VeslRuben/Luretiks-Slange/Pictures/test2jallball.jpg

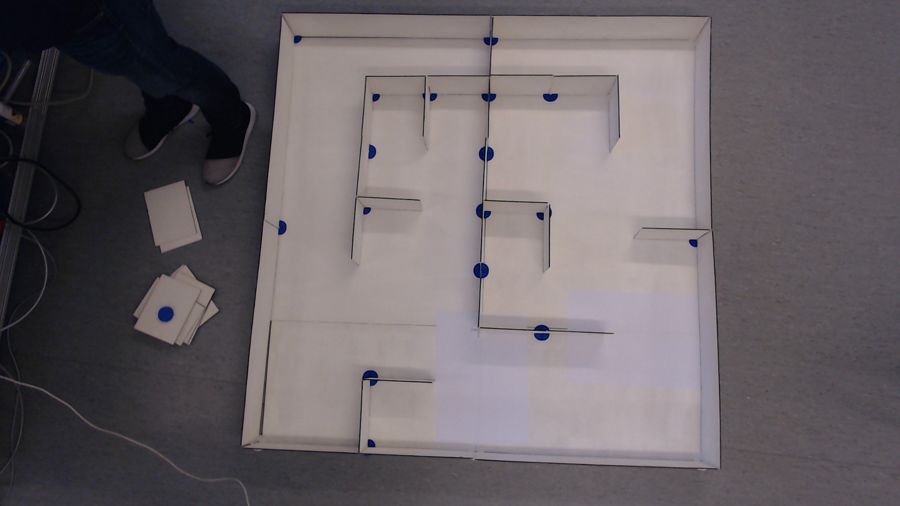
Pictures/test2jallball.jpg
