VeslRuben/Luretiks-Slange/Pictures/Front kamera/8.jpeg

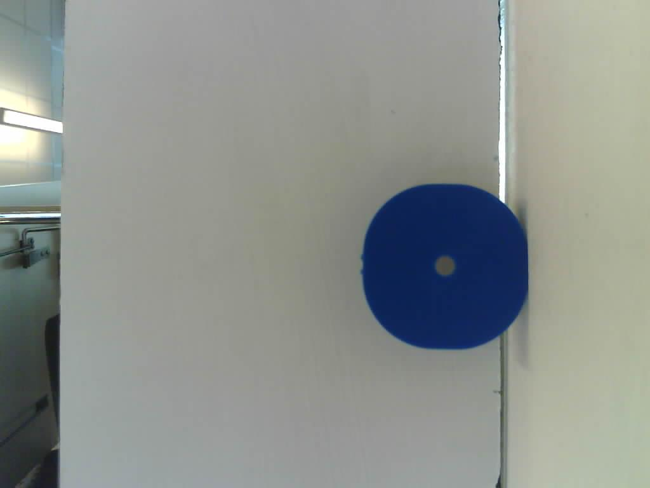
Pictures/Front kamera/8.jpeg
