VeslRuben/Luretiks-Slange/Documents/Handleliste.docx

# Components needed:

- ESP32
- Logic Level Shifter, 8 channel - https://no.rs-online.com/web/p/processor-microcontroller-development-kits/1346479/
- 6x Batteries - https://no.rs-online.com/web/p/lithium-rechargeable-batteries/1251266/
  - Optimal with 6 batteries, minimum requirement is 3 batteries.
