VeslRuben/Luretiks-Slange/Documents/graf.png

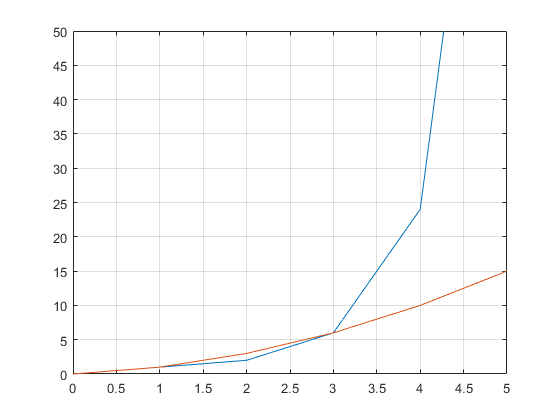
Documents/graf.png
