VeslRuben/Luretiks-Slange/Documents/ingeniorgui.png

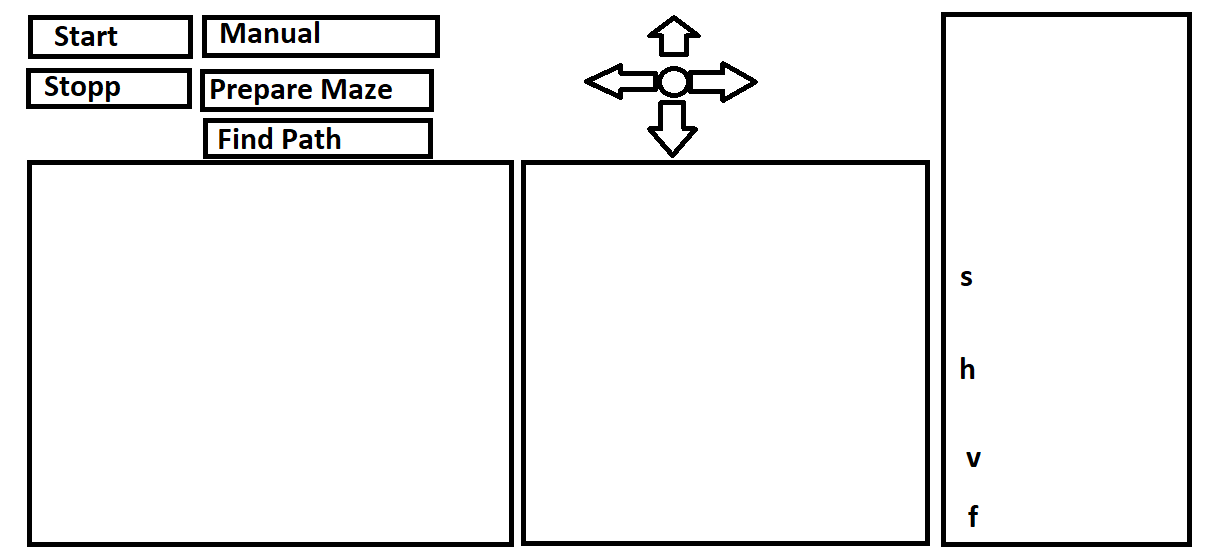
Documents/ingeniorgui.png
