VeslRuben/Luretiks-Slange/Documents/maskebilde1.png

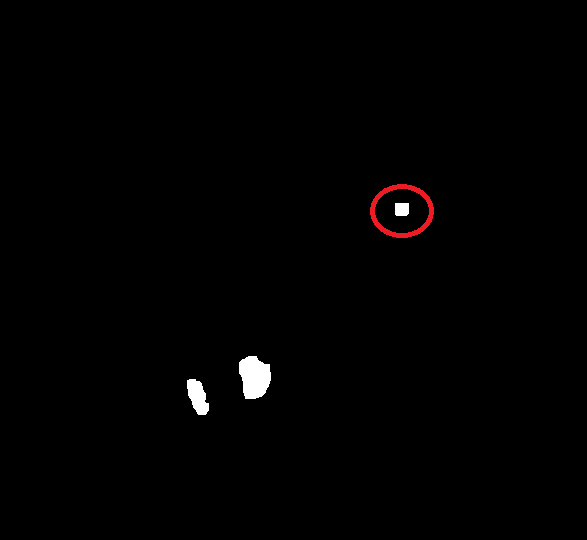
Documents/maskebilde1.png
