VeslRuben/Luretiks-Slange/Documents/maskebilde2.png

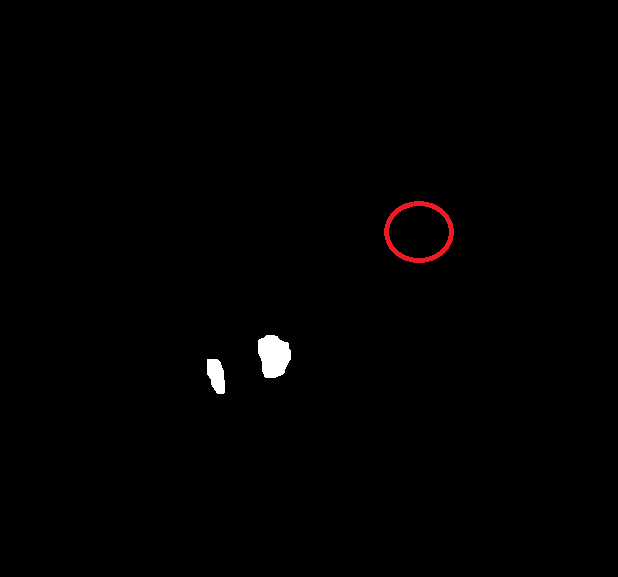
Documents/maskebilde2.png
