VeslRuben/Luretiks-Slange/Documents/mazepic.jpg

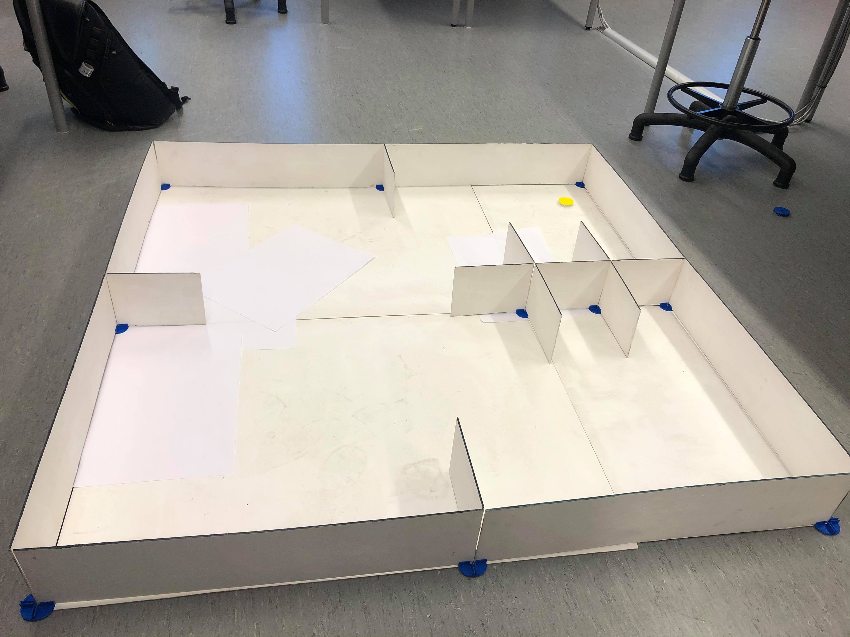
Documents/mazepic.jpg
