VeslRuben/Luretiks-Slange/Pictures/DeadEnds/DeadEnd1.PNG

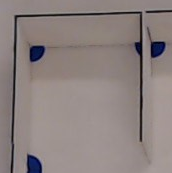
Pictures/DeadEnds/DeadEnd1.PNG
