VeslRuben/Luretiks-Slange/Pictures/DeadEnds/DeadEnd2.PNG

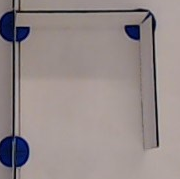
Pictures/DeadEnds/DeadEnd2.PNG
