VeslRuben/Luretiks-Slange/Pictures/DeadEnds/DeadEnd3.PNG

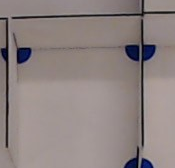
Pictures/DeadEnds/DeadEnd3.PNG
