VeslRuben/Luretiks-Slange/Pictures/DeadEnds/DeadEnd6.PNG

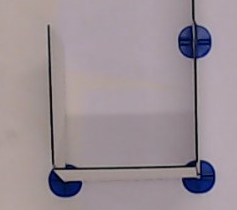
Pictures/DeadEnds/DeadEnd6.PNG
