VeslRuben/Luretiks-Slange/Pictures/DeadEnds/DeadEnd7.PNG

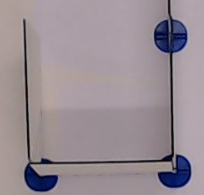
Pictures/DeadEnds/DeadEnd7.PNG
