VeslRuben/Luretiks-Slange/Pictures/DeadEnds/DeadEnd8.PNG

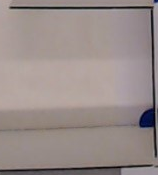
Pictures/DeadEnds/DeadEnd8.PNG
