VeslRuben/Luretiks-Slange/Pictures/DeadEnds/DeadEnd9.PNG

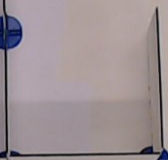
Pictures/DeadEnds/DeadEnd9.PNG
