VeslRuben/Luretiks-Slange/Pictures/DeadEnds/DeadEnd10.PNG

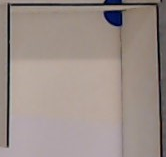
Pictures/DeadEnds/DeadEnd10.PNG
