VeslRuben/Luretiks-Slange/Pictures/DeadEnds/DeadEnd11.PNG

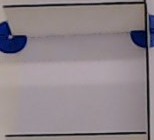
Pictures/DeadEnds/DeadEnd11.PNG
