VeslRuben/Luretiks-Slange/Pictures/DeadEnds/DeadEnd12.PNG

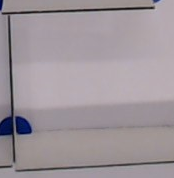
Pictures/DeadEnds/DeadEnd12.PNG
