VeslRuben/Luretiks-Slange/Pictures/DeadEnds/DeadEnd13.PNG

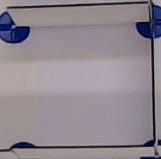
Pictures/DeadEnds/DeadEnd13.PNG
