VeslRuben/Luretiks-Slange/Pictures/DeadEnds/DeadEnd14.PNG

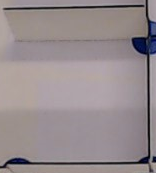
Pictures/DeadEnds/DeadEnd14.PNG
