VeslRuben/Luretiks-Slange/Pictures/DeadEnds/DeadEnd15.PNG

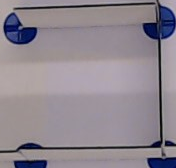
Pictures/DeadEnds/DeadEnd15.PNG
