VeslRuben/Luretiks-Slange/Pictures/DeadEnds/DeadEnd16.PNG

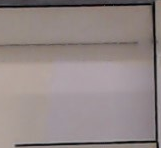
Pictures/DeadEnds/DeadEnd16.PNG
