VeslRuben/Luretiks-Slange/Pictures/DeadEnds/DeadEnd17.PNG

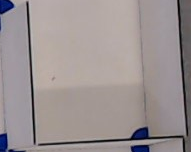
Pictures/DeadEnds/DeadEnd17.PNG
