VeslRuben/Luretiks-Slange/Pictures/DeadEnds/DeadEnd18.PNG

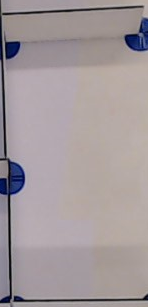
Pictures/DeadEnds/DeadEnd18.PNG
