VeslRuben/Luretiks-Slange/Pictures/DeadEnds/DeadEnd20.PNG

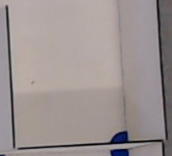
Pictures/DeadEnds/DeadEnd20.PNG
