VeslRuben/Luretiks-Slange/Pictures/DeadEnds/DeadEnd21.PNG

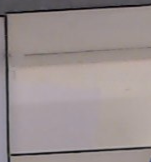
Pictures/DeadEnds/DeadEnd21.PNG
