VeslRuben/Luretiks-Slange/Pictures/DeadEnds/DeadEnd22.PNG

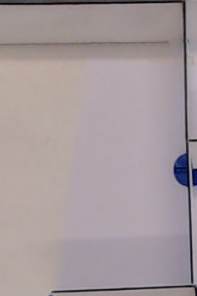
Pictures/DeadEnds/DeadEnd22.PNG
