VeslRuben/Luretiks-Slange/Pictures/DeadEnds/DeadEnd23.PNG

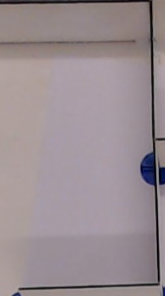
Pictures/DeadEnds/DeadEnd23.PNG
