VeslRuben/Luretiks-Slange/Pictures/DeadEnds/DeadEnd24.PNG

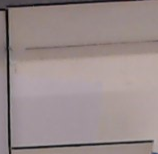
Pictures/DeadEnds/DeadEnd24.PNG
