VeslRuben/Luretiks-Slange/Pictures/DeadEnds/DeadEnd25.PNG

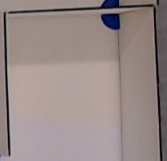
Pictures/DeadEnds/DeadEnd25.PNG
