VeslRuben/Luretiks-Slange/Pictures/DeadEnds/DeadEnd26.PNG

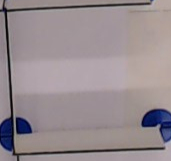
Pictures/DeadEnds/DeadEnd26.PNG
