VeslRuben/Luretiks-Slange/Pictures/DeadEnds/DeadEnd27.PNG

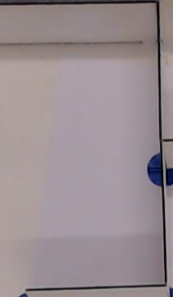
Pictures/DeadEnds/DeadEnd27.PNG
