VeslRuben/Luretiks-Slange/Pictures/DeadEnds/DeadEnd28.PNG

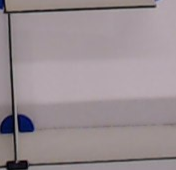
Pictures/DeadEnds/DeadEnd28.PNG
