VeslRuben/Luretiks-Slange/Pictures/DeadEnds/DeadEnd29.PNG

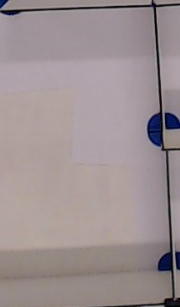
Pictures/DeadEnds/DeadEnd29.PNG
