VeslRuben/Luretiks-Slange/Pictures/DeadEnds/DeadEnd31.PNG

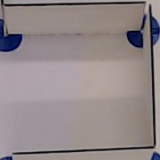
Pictures/DeadEnds/DeadEnd31.PNG
