VeslRuben/Luretiks-Slange/Pictures/DeadEnds/DeadEnd32.PNG

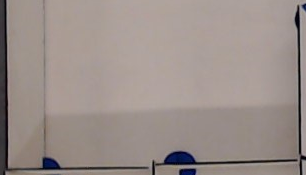
Pictures/DeadEnds/DeadEnd32.PNG
