VeslRuben/Luretiks-Slange/Pictures/DeadEnds/DeadEnd33.PNG

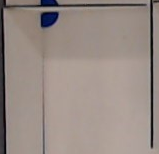
Pictures/DeadEnds/DeadEnd33.PNG
