VeslRuben/Luretiks-Slange/Pictures/DeadEnds/DeadEnd34.PNG

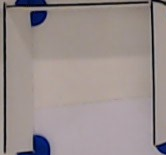
Pictures/DeadEnds/DeadEnd34.PNG
