VeslRuben/Luretiks-Slange/Pictures/DeadEnds/DeadEnd37.PNG

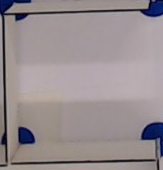
Pictures/DeadEnds/DeadEnd37.PNG
