VeslRuben/Luretiks-Slange/Pictures/DeadEnds/DeadEnd38.PNG

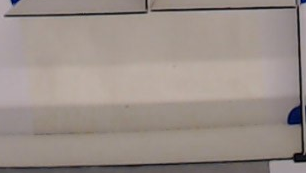
Pictures/DeadEnds/DeadEnd38.PNG
