VeslRuben/Luretiks-Slange/Pictures/DeadEnds/DeadEnd39.PNG

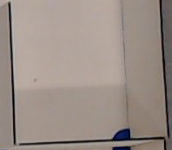
Pictures/DeadEnds/DeadEnd39.PNG
