VeslRuben/Luretiks-Slange/Pictures/DeadEnds/DeadEnd40.PNG

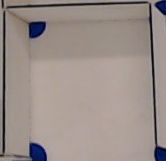
Pictures/DeadEnds/DeadEnd40.PNG
