VeslRuben/Luretiks-Slange/Pictures/DeadEnds/DeadEnd41.PNG

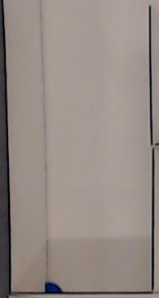
Pictures/DeadEnds/DeadEnd41.PNG
