VeslRuben/Luretiks-Slange/Pictures/DeadEnds/DeadEnd44.PNG

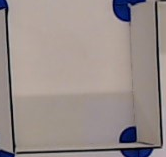
Pictures/DeadEnds/DeadEnd44.PNG
