VeslRuben/Luretiks-Slange/Pictures/DeadEnds/DeadEnd45.PNG

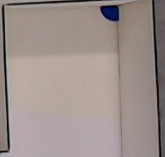
Pictures/DeadEnds/DeadEnd45.PNG
