VeslRuben/Luretiks-Slange/Pictures/DeadEnds/DeadEnd46.PNG

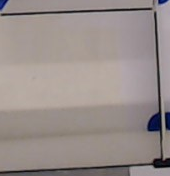
Pictures/DeadEnds/DeadEnd46.PNG
