VeslRuben/Luretiks-Slange/Pictures/Front kamera/0.jpeg

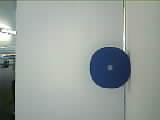
Pictures/Front kamera/0.jpeg
