VeslRuben/Luretiks-Slange/Pictures/Front kamera/6.jpeg

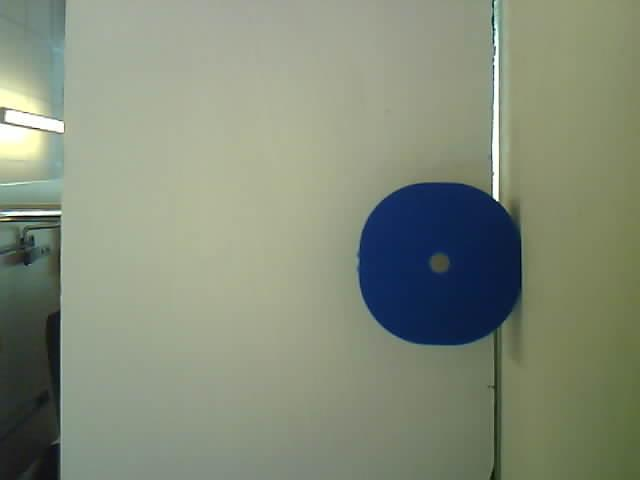
Pictures/Front kamera/6.jpeg
