VeslRuben/Luretiks-Slange/Pictures/jall2.jpg

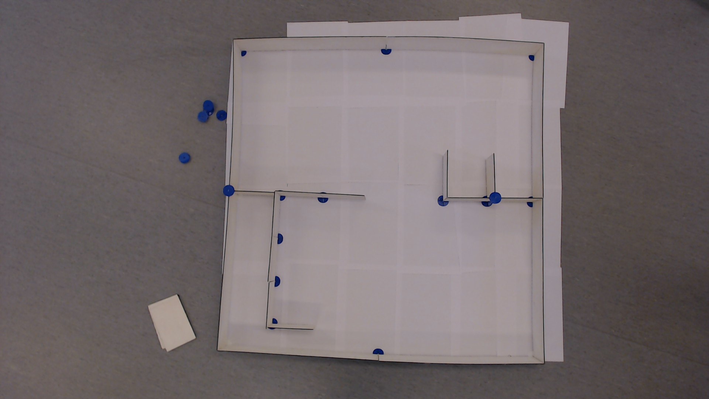
Pictures/jall2.jpg
