VeslRuben/Luretiks-Slange/Pictures/jallaball2.jpg

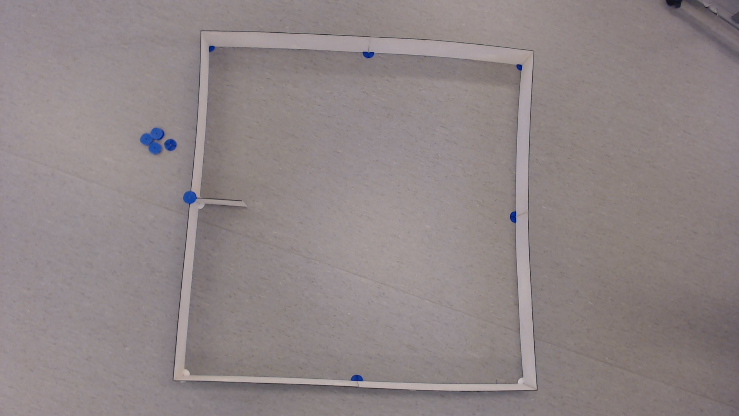
Pictures/jallaball2.jpg
