VeslRuben/Luretiks-Slange/Pictures/jallabilde1.jpg

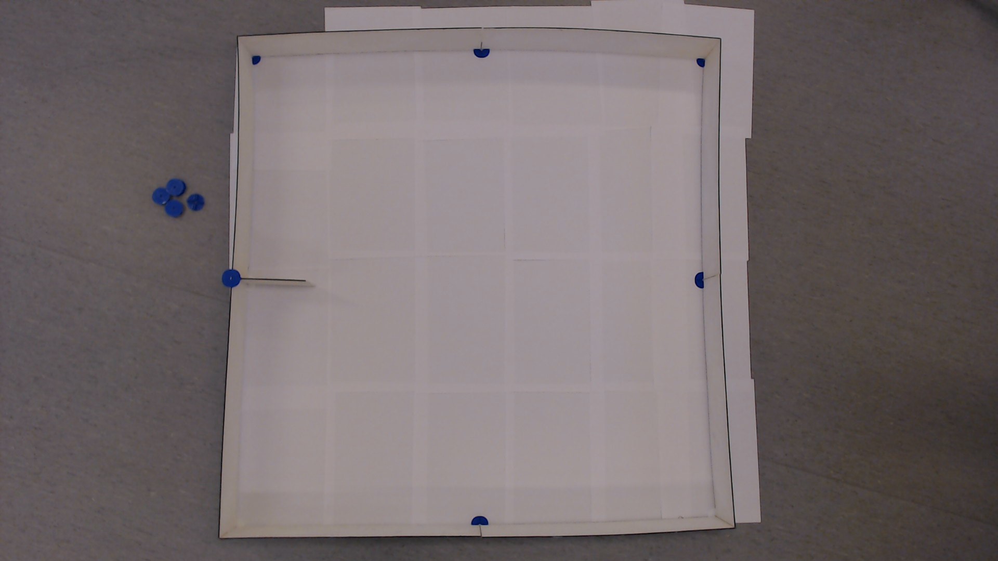
Pictures/jallabilde1.jpg
