VeslRuben/Luretiks-Slange/Pictures/WIN_20191023_11_11_40_Pro.jpg

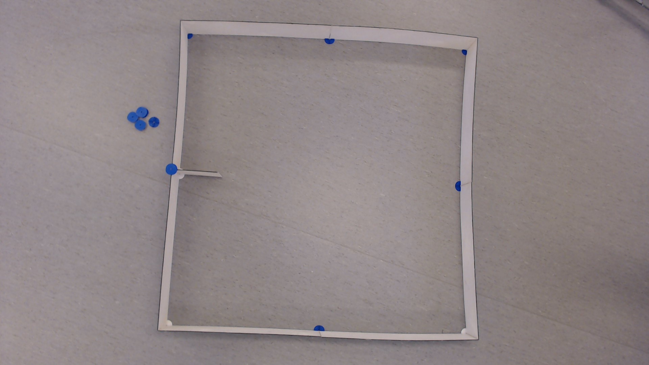
Pictures/WIN_20191023_11_11_40_Pro.jpg
