VeslRuben/Luretiks-Slange/Pictures/WIN_20191023_11_20_51_Pro.jpg

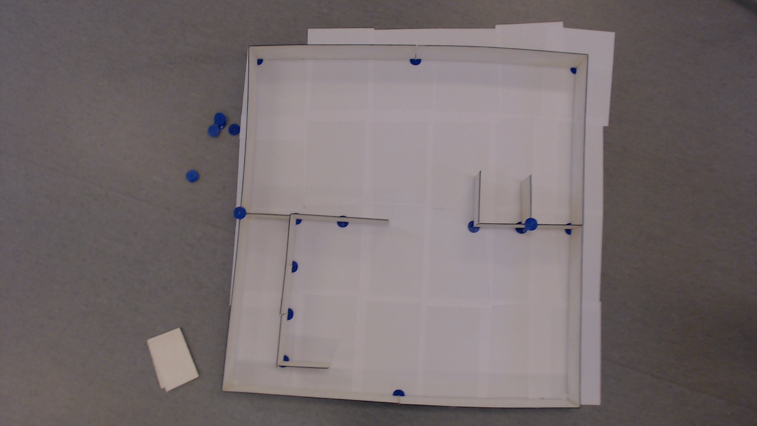
Pictures/WIN_20191023_11_20_51_Pro.jpg
