VeslRuben/Luretiks-Slange/Pictures/WIN_20191023_11_20_55_Pro.jpg

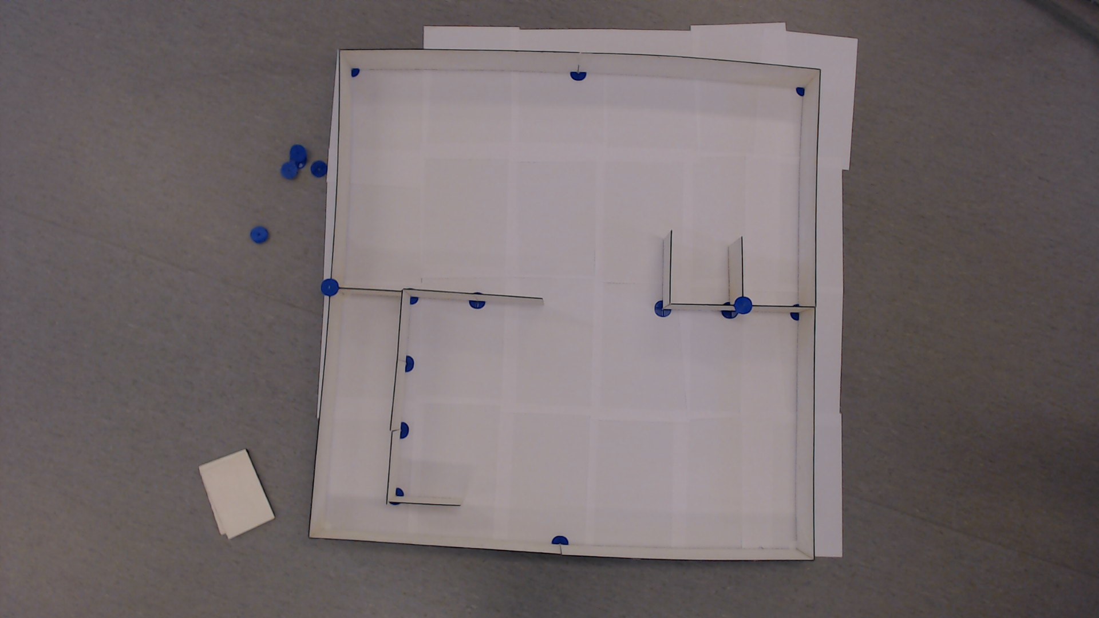
Pictures/WIN_20191023_11_20_55_Pro.jpg
