VeslRuben/Luretiks-Slange/Tegning/Untitled Diagram.png

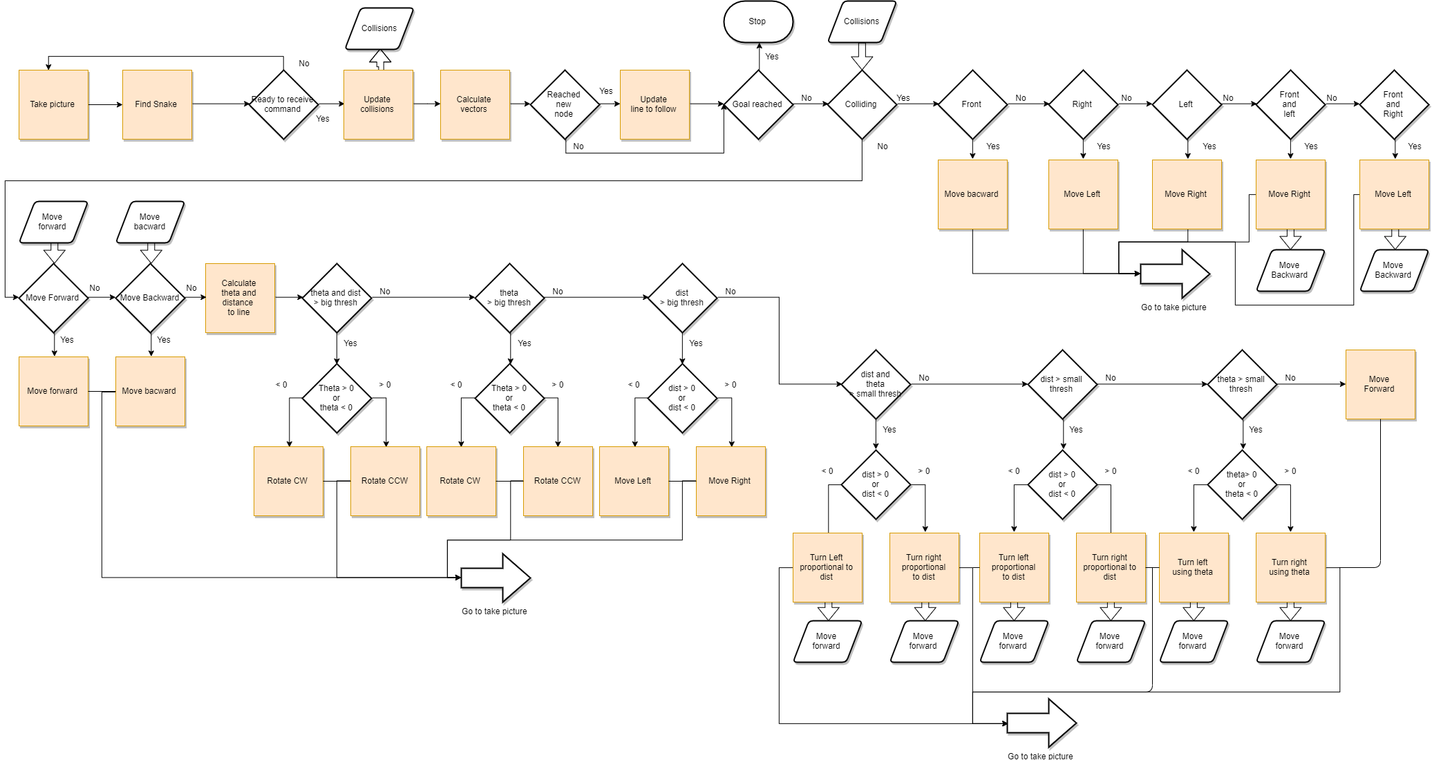
Tegning/Untitled Diagram.png
