VeslRuben/Luretiks-Slange/Tegning/Gcode/UM2_vegg holder.3mf

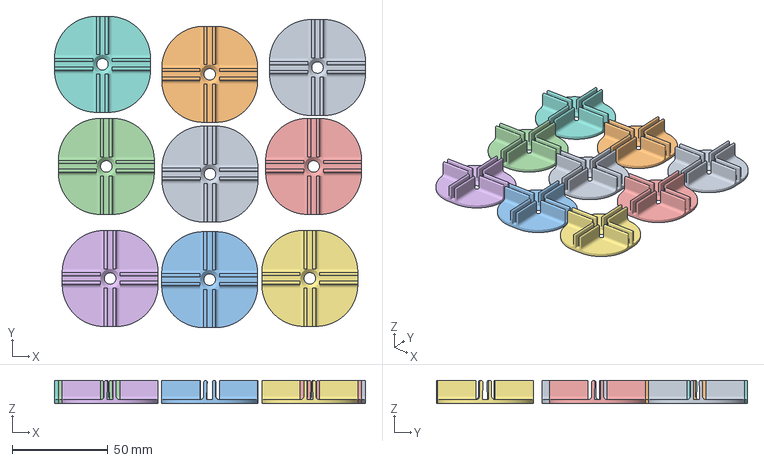
[picture p74: CAD file, 2019-10-16]
Tegning/Gcode/UM2_vegg holder.3mf
162.0 x 162.2 x 12.0 mm
