VeslRuben/Luretiks-Slange/Tegning/STL/V2/10.stl

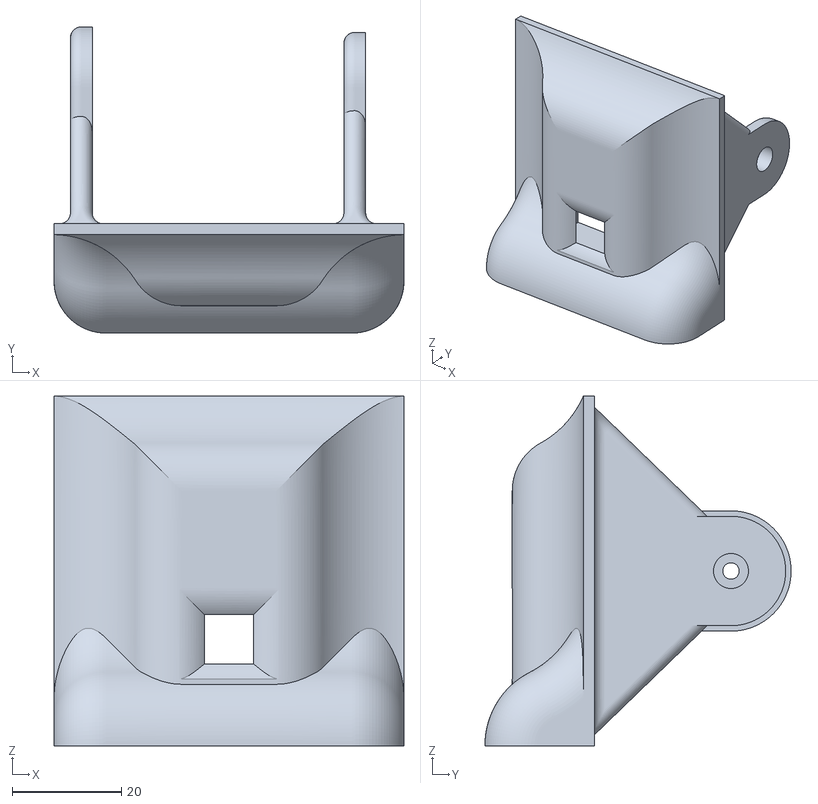
[picture p75: CAD file, 2019-11-01]
Tegning/STL/V2/10.stl
64.0 x 56.0 x 64.0
