VeslRuben/Luretiks-Slange/Tegning/STL/vegg holder.stl

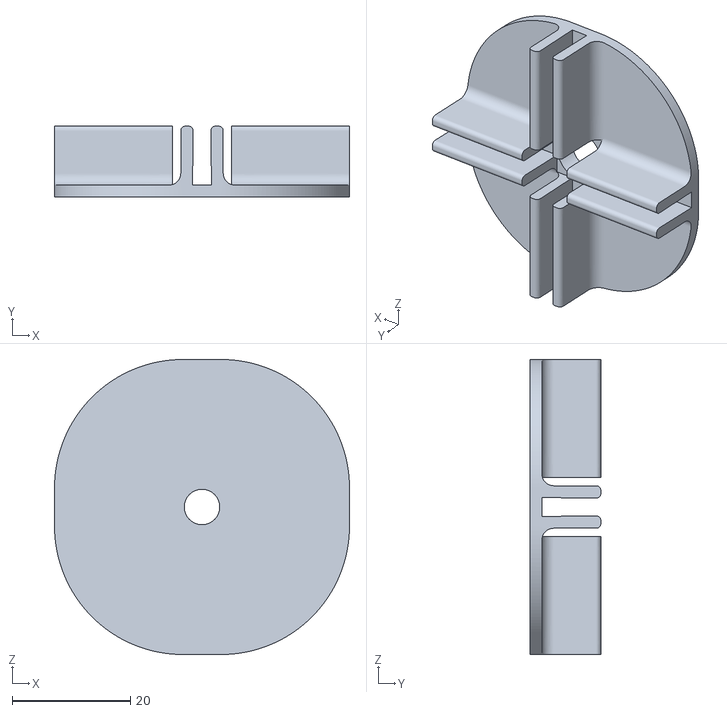
[picture p76: CAD file, 2019-10-21]
Tegning/STL/vegg holder.stl
50.0 x 12.0 x 50.0
