VeslRuben/Luretiks-Slange/Tegning/STL/nesten front.stl

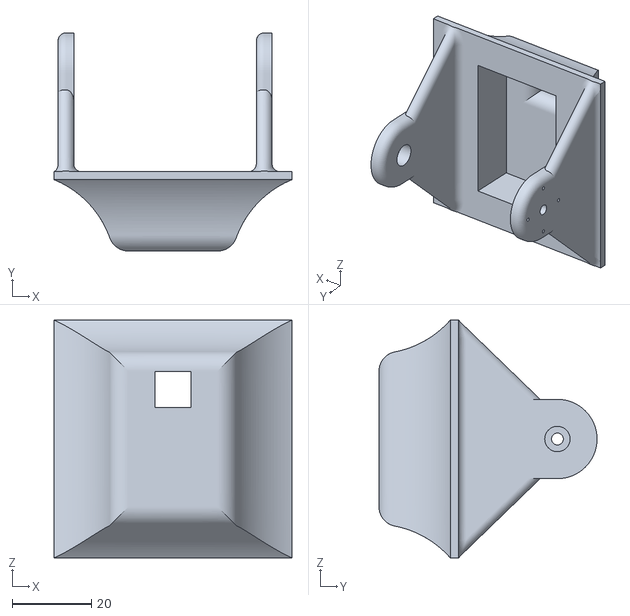
[picture p77: CAD file, 2019-10-21]
Tegning/STL/nesten front.stl
60.0 x 55.0 x 60.0
