VeslRuben/Luretiks-Slange/Tegning/STL/V2/7.stl

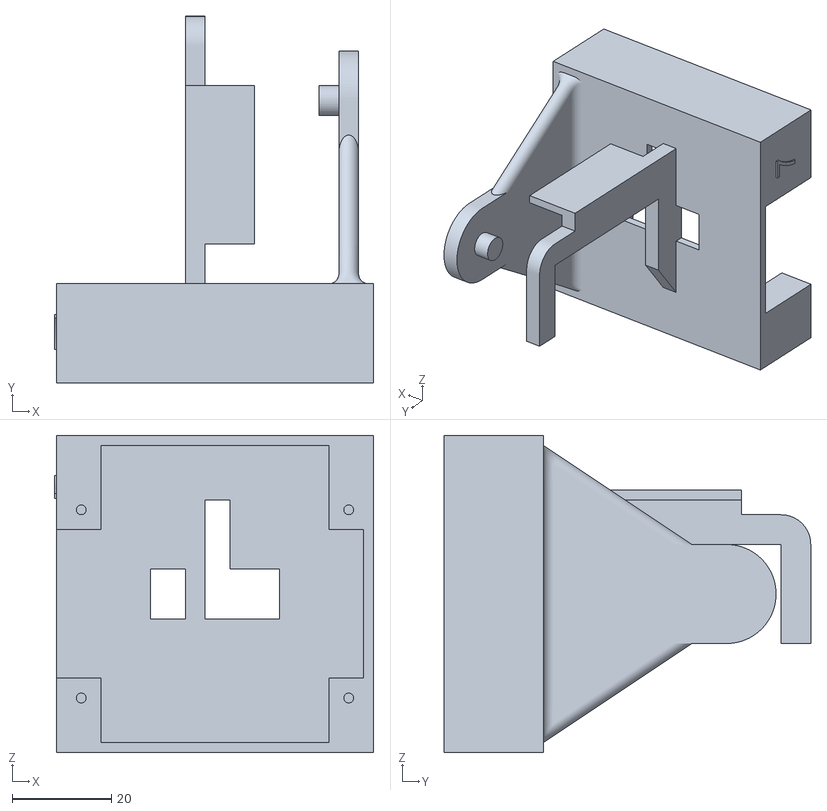
[picture p78: CAD file, 2019-10-23]
Tegning/STL/V2/7.stl
64.4 x 74.0 x 64.0
