VeslRuben/Luretiks-Slange/Tegning/STL/batter holder.stl

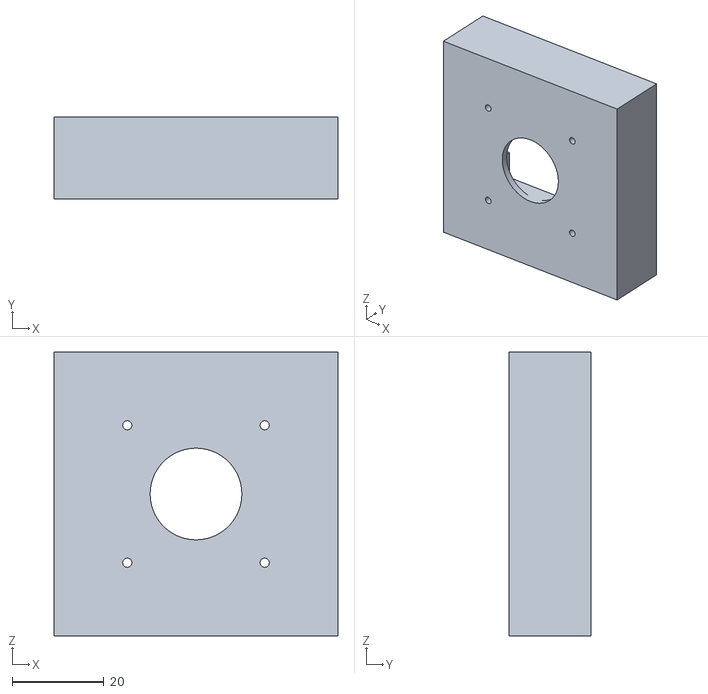
[picture p79: CAD file, 2019-10-16]
Tegning/STL/batter holder.stl
62.0 x 18.0 x 62.0
