VeslRuben/Luretiks-Slange/Tegning/STL/Front.stl

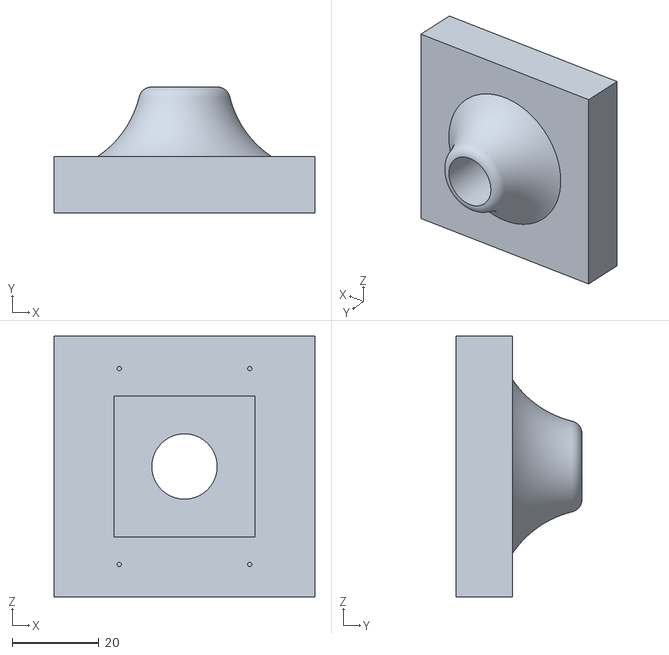
[picture p80: CAD file, 2019-10-16]
Tegning/STL/Front.stl
60.0 x 29.0 x 60.0
