VeslRuben/Luretiks-Slange/Tegning/STL/V2/2.stl

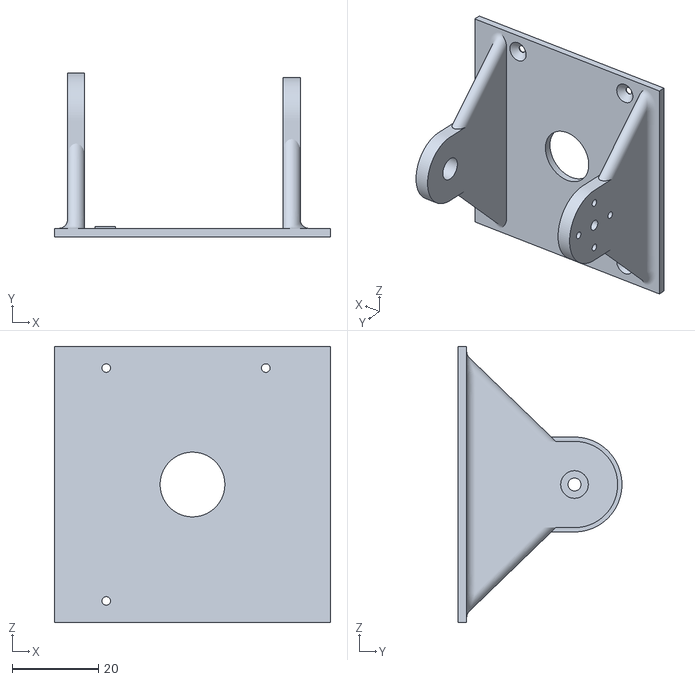
[picture p81: CAD file, 2019-10-23]
Tegning/STL/V2/2.stl
64.0 x 38.0 x 64.0
