VeslRuben/Luretiks-Slange/Tegning/STL/Slange 1.stl

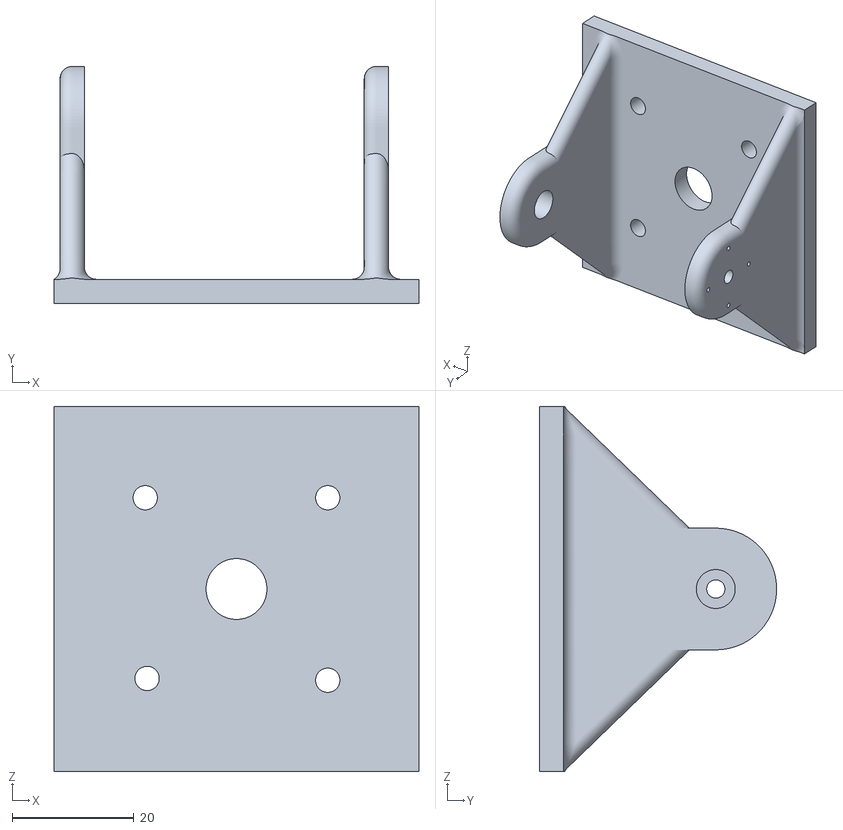
[picture p82: CAD file, 2019-10-16]
Tegning/STL/Slange 1.stl
60.0 x 39.0 x 60.0
