VeslRuben/Luretiks-Slange/Tegning/STL/V2/9.stl

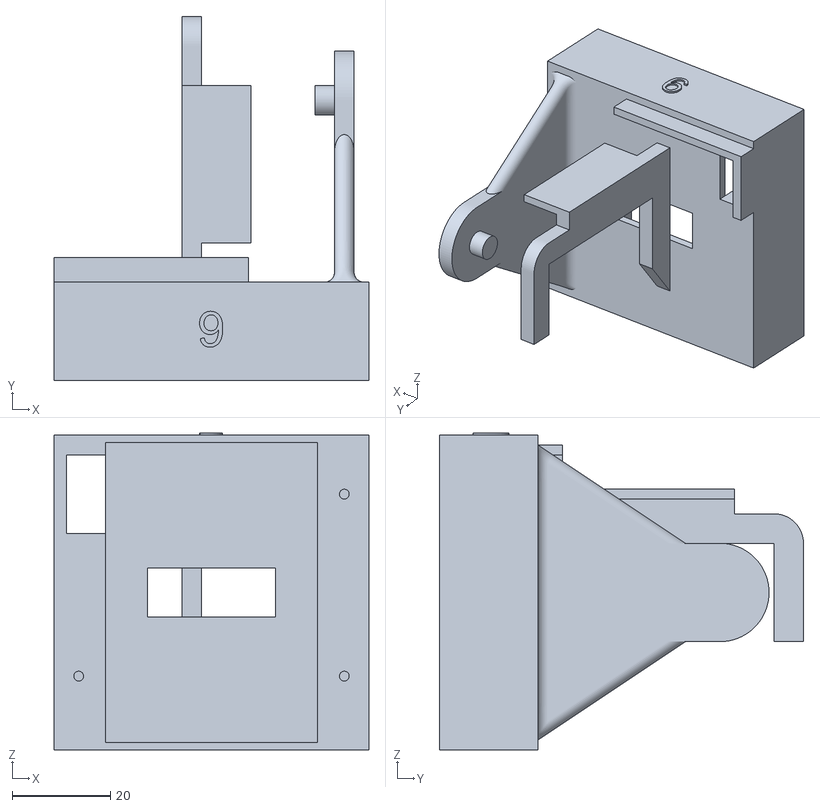
[picture p83: CAD file, 2019-10-23]
Tegning/STL/V2/9.stl
64.0 x 74.0 x 64.4
