VeslRuben/Luretiks-Slange/Tegning/STL/Slange 2.stl

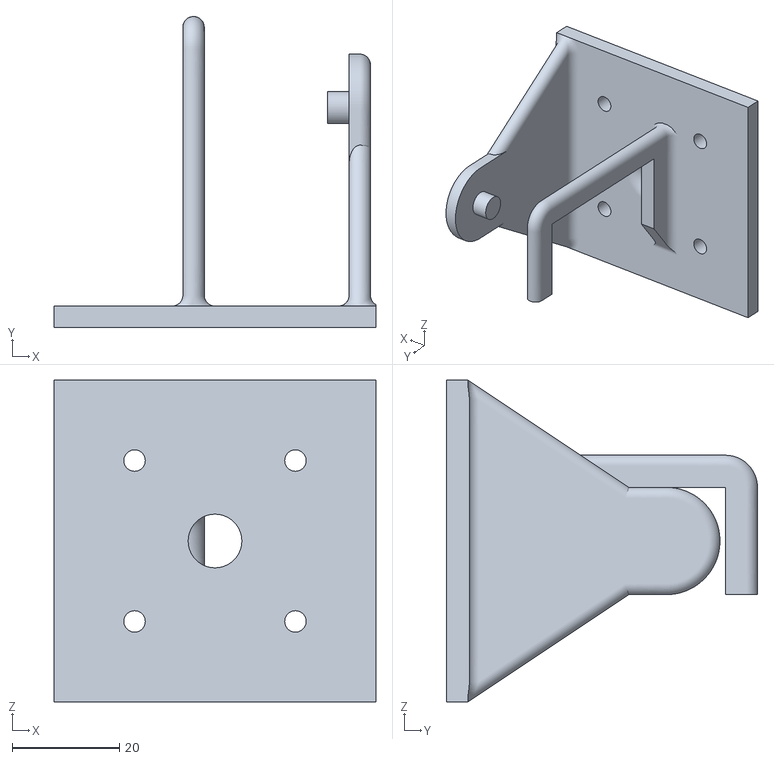
[picture p84: CAD file, 2019-10-16]
Tegning/STL/Slange 2.stl
60.0 x 58.0 x 60.0
