VeslRuben/Luretiks-Slange/(list of files, cad)

Other CAD files:
Tegning/CAD/yttervegger.dwg
Tegning/CAD/vegger.dwg
Tegning/STL/V2/1.stl
Tegning/STL/V2/8.stl
Tegning/STL/V2/5.stl
Tegning/STL/V2/4.stl
Tegning/STL/V2/3.stl
Tegning/STL/V2/6.stl
