VeslRuben/Luretiks-Slange/Documents/TODO.xlsx

Prosjekt slange: | TODO
Ansvarlig | Oppgave | Status | Info
Marcus | Montering | Uferdig | Mangler: 2 boost konvertere
Marcus/Ruben | Lodding | Uferdig | Mangler: Montering, deretter lodding av komponenter
Ruben | Webserver | Uferdig | Testing-phase
Håkon | Webclient | Uferdig | Testing-phase
Håkon/Ruben | Kamera | Uferdig | Må kobles opp, mangler ESP32 med pins. Deretter testing
