VeslRuben/Luretiks-Slange/Tegning/Untitled Diagram.pdf

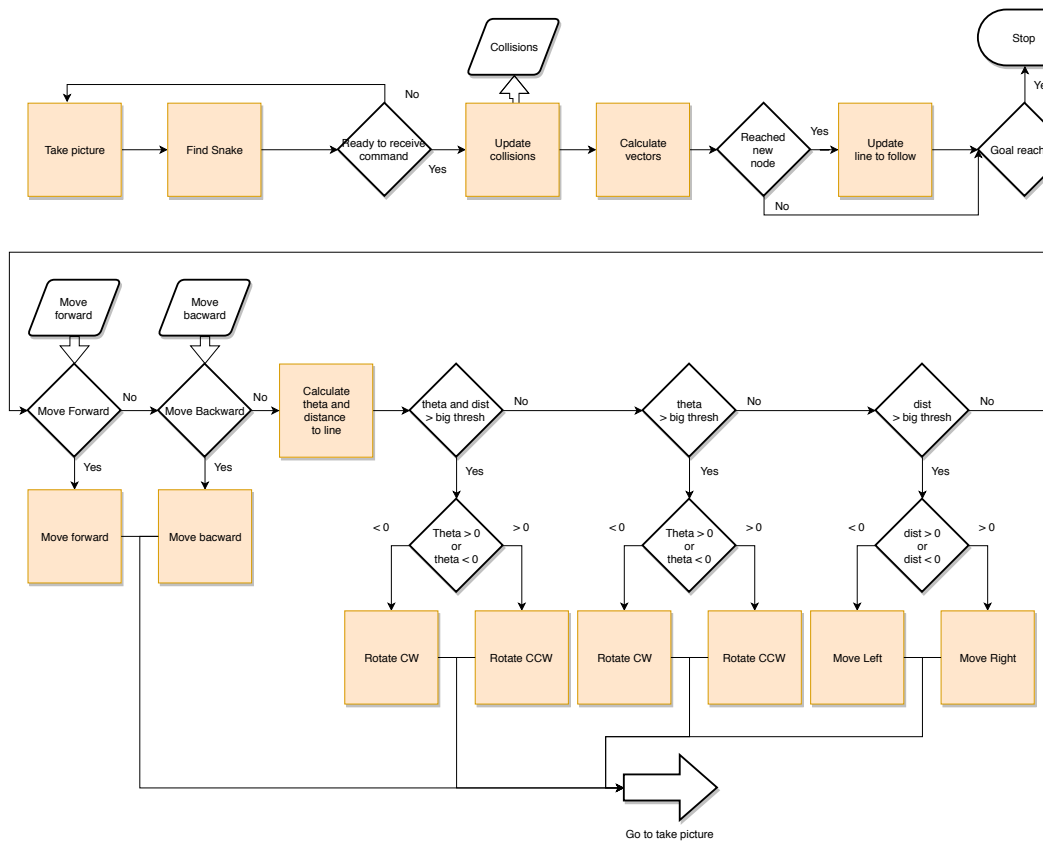
[picture p85: page 1]
Take picture; Find Snake; Yes; Update collisions; Collisions; Calculate vectors; Reached new node; Stop; Goal reach; Calculate theta and distance to line; Theta > 0 or theta < 0; Rotate CW; Rotate CCW; theta > big thresh; dist > big thresh; dist > 0 or dist < 0; Move Left; Move Right; Move Forward; Move forward; Move Backward; Move bacward

Ready to receive
command

Update
line to follow

theta and dist
> big thresh

Go to take picture

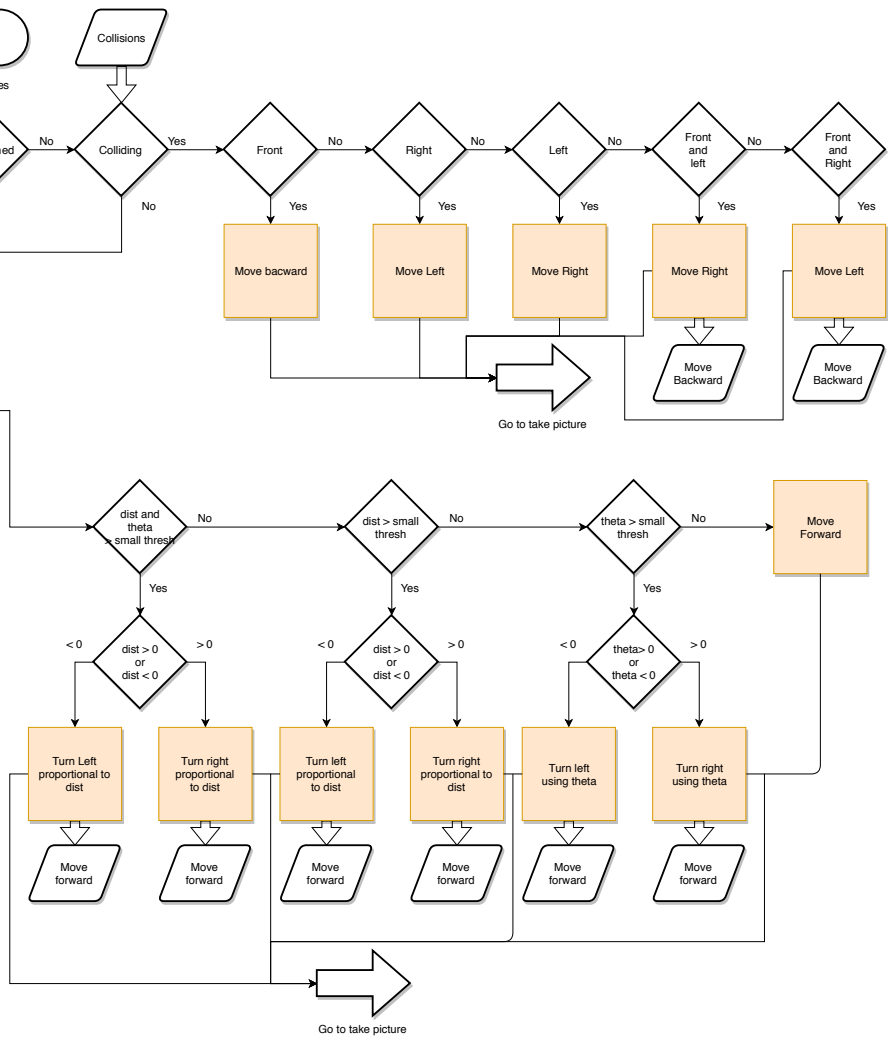
[picture p86: page 2]
hed; Colliding; Collisions; Front; Right; Left; Move bacward; Move Left; Move Right; Front and left; Front and Right; Move Backward; Yes; dist and theta > small thresh; dist > 0 or dist < 0; Turn Left proportional to dist; Turn right proportional to dist; Move forward; dist > small thresh; Turn left proportional to dist; theta > small thresh; theta> 0 or theta < 0; Turn left using theta; Turn right using theta; Move Forward

Go to take picture
