VeslRuben/Luretiks-Slange/Arduino/completeArduinoProgram/completeArduinoProgram.ino

#include <Servo.h>
#include <WiFi.h>
#include <math.h>


//////////////////////////////////////////////
// WIFI VARIABLES
/////////////////////////////////////////////
// Information for connecting to WiFi
const char* ssid = "MSI";
const char* password =  "12345678";

// Information for sending information via UDP
const uint16_t port = 6969;
const char * host = "192.168.137.1";

// Test array for sending
int jallaball[100][200];

// Flag for sending packet only once
boolean notSent = false;

// Buffer for packetsize
byte packetBuffer[128];

// Establish the UDP-Client
WiFiUDP udpClient;

// Timer for sending message
unsigned int aliveTimer = 0;

/////////////////////////////////////////////
// MOVEMENT VARIABLES
/////////////////////////////////////////////

const int numberOfServos = 5;

// Establish servo array
Servo myServo[numberOfServos];

// Amplitude for the servos
int A = 40;

// Different phase shifts for the different movement
float forwardPhi = (120.0 / 180.0) * M_PI;
float lateralPhi = (100.0 / 180.0) * M_PI;
float rollingPhi = (90.0 / 180.0) * M_PI;
float rotatePhiV = (120.0 / 180.0) * M_PI;
float rotatePhiH = (50.0 / 180.0) * M_PI;

// Time constant
int T = 1000;

//Variable for speed of servos
int servSpeed = 0;

// DO NOT USE PINS 12-17, THESE MAKE PARSEPACKET CRASH THE WHOLE FUCKING SHIT
// SERVO LIBRARIES ARE FUCKING MORONIC
int servPins[5] = {4, 23, 22, 21, 25};

// Zero-point array for servos
int servZero[5] = {90, 93, 97, 87, 99};

// Booleans for movement
boolean goingForward = false;
boolean goingBackward = false;

/////////////////////////////////////////
// SETUP
/////////////////////////////////////////

void setup()
{
  Serial.begin(115200);

  ///////////////////////////
  // WIFI RELATED
  //////////////////////////

  // Starting wifi
  WiFi.begin(ssid, password);

  // Trying to connect to WiFi
  while (WiFi.status() != WL_CONNECTED) {
    delay(500);
    Serial.println("...");
  }
  Serial.print("WiFi connected with IP: ");
  Serial.println(WiFi.localIP());

  // Making 2D array to send
  for (int i = 0; i < 100; i++) {
    for (int j = 0; j < 200; j++) {
      jallaball[i][j] = 1;
    }
  }

  // Begin listening on port 9696
  udpClient.begin(9696);

  // Set the first timer
  aliveTimer = millis() + 500;

  ////////////////////////////
  // MOVEMENT RELATED
  ///////////////////////////

  // Establishing the servos in an array
  for (int i = 0; i < 0 + numberOfServos; i++) {
    myServo[i].attach(servPins[i]);
    myServo[i].write(servZero[i]);
  }
}

void loop()
{
  sendAliveMessage();
  char command = checkPackets();
  if (command != 'z') {
    if (command == 'f') {
      Serial.println("Going forward");
      goingForward = true;
      goingBackward = false;
    } else if (command == 'b') {
      Serial.println("Going backwards");
      goingForward = false;
      goingBackward = true;
    } else if (command == 'v') {
      Serial.println("Adjusting left");
      goLeft();
    } else if (command == 'h') {
      Serial.println("Adjusting right");
      goRight();
    } else if (command == 's') {
      Serial.println("Stopping movement");
      goingForward = false;
      goingBackward = false;
    } else if (command == 'r') {
      Serial.println("Adjusting straight");
      goingForward = false;
      goingBackward = false;
      goStraight();
    } else if (command == 't') {
      int numb1 = (int)packetBuffer[1] - 48;
      int numb2 = (int)packetBuffer[2] - 48;
      int numb3 = (int)packetBuffer[3] -48;
      int sum = numb1 * 100 + numb2 * 10 + numb3;
      Serial.println(sum);
      turn(sum);
    } else {
      Serial.println("Unknown command");
      sendErrorToServer();
    }
  }
  if (goingForward) {
    goForward();
  } else if (goingBackward) {
    goBackward();
  }
}



////////////////////////////////
// WIFI FUNCTIONS
////////////////////////////////

char checkPackets() {
  if (udpClient.parsePacket()) {
    Serial.println("Packet received");
    udpClient.read(packetBuffer, 128);
    Serial.println(char(packetBuffer[0]));
    return packetBuffer[0];
  } else {
    return 'z';
  }
}

void sendErrorToServer() {
  udpClient.beginPacket(host, port);
  udpClient.write('x');
  udpClient.endPacket();
}

void sendAliveMessage() {
  if (aliveTimer < millis()) {
    udpClient.beginPacket(host, port);
    udpClient.write('a');
    udpClient.endPacket();
    aliveTimer = millis() + 500;
  }
}

void sendPacketOnce() {
  if (!notSent) {
    udpClient.beginPacket(host, port);
    udpClient.write('a');
    udpClient.endPacket();
    udpClient.beginPacket(host, port);
    int numRows = sizeof(jallaball) / sizeof(jallaball[0]);
    int numCols = sizeof(jallaball[0]) / sizeof(jallaball[0][0]);
    udpClient.write(char(numRows));
    udpClient.write(' ');
    udpClient.write(char(numCols));
    udpClient.endPacket();
    delay(50);
    udpClient.beginPacket(host, port);
    for (int i = 0; i < numRows; i++) {
      for (int j = 0; j < numCols; j++) {
        udpClient.write(jallaball[i][j]);
      }
    }
    udpClient.endPacket();
    udpClient.beginPacket(host, port);
    udpClient.write('f');
    udpClient.endPacket();
    notSent = true;
    Serial.println("Finished sending");
  }
}

///////////////////////////////////////////
// MOVEMENT FUNCTIONS
///////////////////////////////////////////
void goForward() {
  for (int i = 0; i < 3; i++) {
    myServo[i * 2].write(servZero[i * 2] + updateAngle(T, i * forwardPhi, A));
  }
}

void goBackward() {
  for (int i = 2; i >= 0; i--) {
    myServo[i * 2].write(servZero[i * 2] + updateAngle(T, -i * forwardPhi, A));
  }
}

void turn(int deg) {
  if (deg < 45){
    deg = 45;
  } else if (deg > 135) {
    deg = 135;
  }
  for (int i = 0; i < 2; i++) {
    myServo[(i * 2) + 1].write(deg + servZero[(i * 2) + 1] - 90);
  }
}

void goLeft() {
  int movement = myServo[1].read() - 3;
  if (movement < 45) {
    movement = 45;
  }
  for (int i = 0; i < 2; i++) {
    myServo[(i * 2) + 1].write(movement);
  }
}

void goRight() {
  int movement = myServo[1].read() + 3;
  if (movement > 135) {
    movement = 135;
  }
  for (int i = 0; i < 2; i++) {
    myServo[(i * 2) + 1].write(movement);
  }
}

/////////////////////
// MÅ FIKSE FOR-LOOP FOR SVINGENDE LEDD
// PÅ DE TRE NEDENFOR
/////////////////////

void lateralShift() {
  for (int i = 0; i < 3; i++) {
    myServo[i * 2].write(servZero[i * 2] + updateAngle(T, i * lateralPhi, A));
    if (i < 2) {
      myServo[(i * 2) + 1].write(servZero[(i * 2) + 1] + updateAngle(T, i * lateralPhi, A));
    }
  }
}

void doARoll() {
  for (int i = 0; i < 3; i++) {
    myServo[i * 2].write(servZero[i * 2] + updateAngle(T, 0, A));
    if (i < 2) {
      myServo[(i * 2) + 1].write(servZero[(i * 2) + 1] + updateAngle(T, 90, A));
    }
  }
}

void rotatingGait() {
  for (int i = 0; i < 3; i++) {
    myServo[i * 2].write(servZero[i * 2] + updateAngle(T, i * rotatePhiV, A));
    if (i < 2) {
      myServo[(i * 2) + 1].write(servZero[(i * 2) + 1] + updateAngle(T, i * rotatePhiH, A));
    }
  }
}

void goStraight() {
  for (int i = 0; i < 5; i++) {
    myServo[i].write(servZero[i]);
  }
}

int updateAngle(float T, float phase, float A) {
  float y = A * sin(((2 * M_PI) / T) * millis() + phase);
  return y;
}
