VeslRuben/Luretiks-Slange/(commit log)

2019-10-09 Added arduino-file for testing purposes
2019-10-15 Added project planner-file, added Arduino-file for Movement.
    [ProjectPlanner.xlsx]
2019-10-15 Updatet Project Planner, Added Rapport-file.
    [ProjectPlanner.xlsx]
2019-10-16 Addet drawings and 3d print fils
    [Front.stl, Slange del 1.stl, Slange del 2.stl, nesten front.stl, vegg holder.stl, vegger.dwg, yolo1.stl, yolo2.stl]
2019-10-16 fikst som names
    [Slange 1.stl, Slange 2.stl, Slange del 1.stl, Slange del 2.stl]
2019-10-16 Finished movement-code. Need to test when robot is assembled. Updated projectplanner to reflect this work done.
    [ProjectPlanner.xlsx]
2019-10-16 Added new file for report. Added arduino-code for wifi-module.
2019-10-16 fikst aduino code so it can read from web server and added python veb server
    [UM2_vegg holder.3mf, batter holder.stl]
2019-10-17 Added file for TODO. Added camera-module to arduino. Fixed the wifi-module to now send packets via UDP.
    [TODO.xlsx]
2019-10-18 Updated documents. Added wifi-module to movement-module and combined for Complete program for arduino. Btw, dont use pin 12-17 for servo, this makes the ESP32 crash when trying to parse incoming pack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
    [ProjectPlanner.xlsx]
2019-10-21 Started RRT-algorithm-making. Changed some pins for the servos in the arduino program.
2019-10-21 Create a class to get images form te esp32 camera. Crated a logger class for logging eventns in the program
    updatet gitignor to not add logs to git
    [nesten front.stl, vegg holder.stl, yttervegger.dwg]
2019-10-21 Updated project planner and wrote some documentation in the report concerning communication between ESP32 and PC, as well as between camera-module and python.
    [ProjectPlanner.xlsx]
2019-10-23 Taken some test pictures to filter the maze. Found edges, made lines with algorithm. Sent those lines to the RRT*-function. Updated projectplanner and report.
    [ProjectPlanner.xlsx]
2019-10-23 added stlf fils.
    updatet arduino code
    [1.stl, 10.stl, 2.stl, 3.stl, 4.stl, 5.stl, 6.stl, 7.stl]
2019-10-24 Adjusted rrt_star and rrt to limit node-placement in x and y directions separately. Added some more filtering on the image of the maze to get less lines, and a more representative view of the maze.
2019-10-25 Adjusted the collision-detection in RRT, it now will keep the lines at a minimum of 20 pixels (adjustable in main) from the walls of the maze. Updated the filter in maze-recognizer.
    [ProjectPlanner.xlsx]
2019-10-25 Fixed the arduino program to take into account the different zeropoints of the servos. Made an array that it gets the zeropoints from. Implemented it in code.
    [completeArduinoProgram.ino]
2019-10-25 Fixed so the reset-command stops movement, then adjusts everyone to zero-point.
    [completeArduinoProgram.ino]
2019-10-29 Added pictures for the report. Started working more on the report.
    [ProjectPlanner.xlsx]
2019-10-30 Createt and startet implementing a camera class. the class maks it so mor the one class can use the overhead camera
2019-10-30 upadtet camera class en tetet it in te gui
2019-10-30 Fancy shit. Added live picture taking for when pressing GUI-buttons. Other shit, gotta go.-
2019-11-01 implemented average filter for fine snake
    [10.stl]
2019-11-02 Change some ofe parameter for the collor finding.
    implementet e simpel P regulator so de snak kan follow a line
2019-11-02 Cange the code so de snake use distance to lin isted of angle betwen vektors for te P regulator.
    changet te saklar ofr the lien ust to determen if te snak has reatct a node. the line was so log the snak trigert next node if it was 180 deg turnd
2019-11-08 added possibility for testing RRT and RRT* with test pictures. Added new Arduino-program for testing new communication-protocol. Continued work on report.
2019-11-12 Detect deadEnds class made, and found lines of dead ends. Now we need to find out if they intersect other lines And made it so the top camera, can find object, like a yellow ball. in case the front m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
2019-11-13 General spellchecking. Updated Arduino-program to make use of lateral shifts. Updated project planner. Cleaned up Arduino code to remove redundant lines.
    [ProjectPlanner.xlsx]
2019-11-17 Finished the new controller that will take collisions into account. What it does in a situation of collisions is not yet defined. But it will now implement rotation if the angle is off, and the dista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
    [completeArduinoProgramTEST.ino]
2019-11-21 Added functionality to prepare maze for Seek and Destroy.
    [ProjectPlanner.xlsx]
2019-11-22 Added functionality to the find path-button for seek and destroy.
2019-11-22 Implemented obstacle detection for frontfacing camera
2019-11-25 General typo-fixing. Changed some variable names to make more sense.
    [ProjectPlanner.xlsx]
2019-11-26 Added print to better see where the multiRRT is in the processing of the paths.
2019-11-26 added flowchart
2019-12-02 Added documentation to every class. Program is considered done.
    [ProjectPlanner.xlsx]
2019-12-03 Added print in main to know that the file was saved. Changed how the timeout in GoToTarget works.
    [ProjectPlanner.xlsx]
2019-12-04 Added som external files. Cleaned up a bit of code in RRT. Nothing new.
    [ProjectPlanner.xlsx]
